AmeenAlShaibani/BLE-RC-car/Docs/Board3D_Back.png

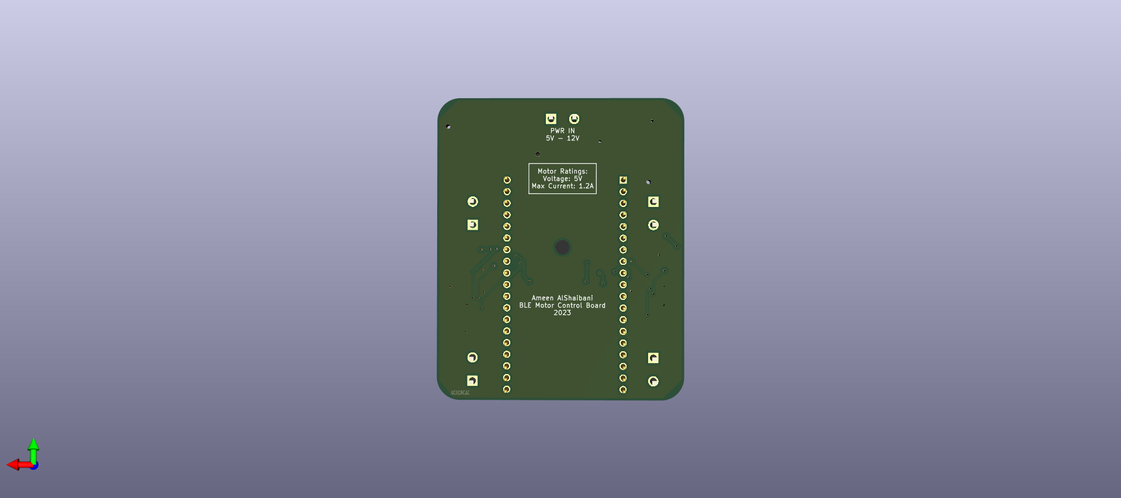
Docs/Board3D_Back.png
