AmeenAlShaibani/BLE-RC-car/README.md

The goal of this project is to create an Android app accompanied by a motherboard for an RC car. The motherboard will handle signal, and power distribution to the motors,
and will use BLE technology to connect to the Android app such that the RC car can be controlled remotely.
