AmeenAlShaibani/BLE-RC-car/Docs/ESP32_BLEPowerConsumption.png

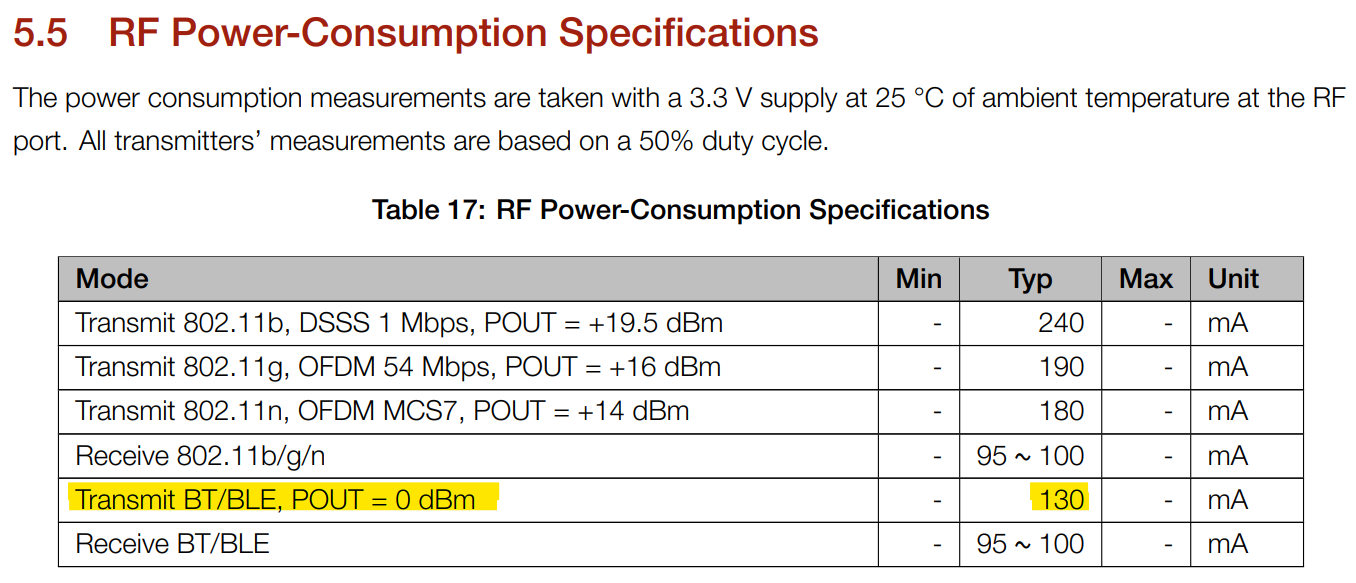
Docs/ESP32_BLEPowerConsumption.png
