AmeenAlShaibani/BLE-RC-car/Manufacturing/production/bom.csv

Designator | Footprint | Quantity | Value | LCSC Part #
C1, C10, C12, C3 | 0402 | 4 | 0.1uF
C11, C13, C2, C4, C5, C8, C9 | 1206 | 7 | 10uF
C6, C7 | CAPMP7343X310N | 2 | 100uF
J1, J2, J3, J4, J5 | 1760490000 | 5 | 1760510000
R1, R2 | 0805 | 2 | 10k
U1 | MODULE_ESP32-DEVKITC-32D | 1 | ESP32-DEVKITC-32D
U2 | SOT95P240X105-3N | 1 | DMG3415U-7 | DMG3415U-7
U3, U4 | SSOP-24_5.3x8.2mm_P0.65mm | 2 | TB6612FNG
U5 | SOT230P700X185-4N | 1 | AZ1117IH-3.3TRG1
U6 | TO-263-3_TabPin2 | 1 | LM1085-5.0
