AmeenAlShaibani/BLE-RC-car/Docs/PowerCalculations.xlsx

Components | Maximum Expected Current Consumption (mA) | Quantity | Total (mA)
ESP32 | 600 | 1 | 600
3-6V DC Motors | 1300 | 4 | 5200
 |  |  | 5800
Battery Requirements
Voltage: | 3.3-6V
Current | 5800
Battery Options
AA Battery: | 1.5V | 2000mAh
D Cell Battery | 1.5V | 15000 mAh | Source | https://www.supplyhog.com/c/electrical/batteries-flashlights/household-batteries/p/duracell-coppertop-alkaline-battery-7
C Cell Battery | 1.5V | 7000 mAh
