AmeenAlShaibani/BLE-RC-car/Docs/BoardSchematic.pdf

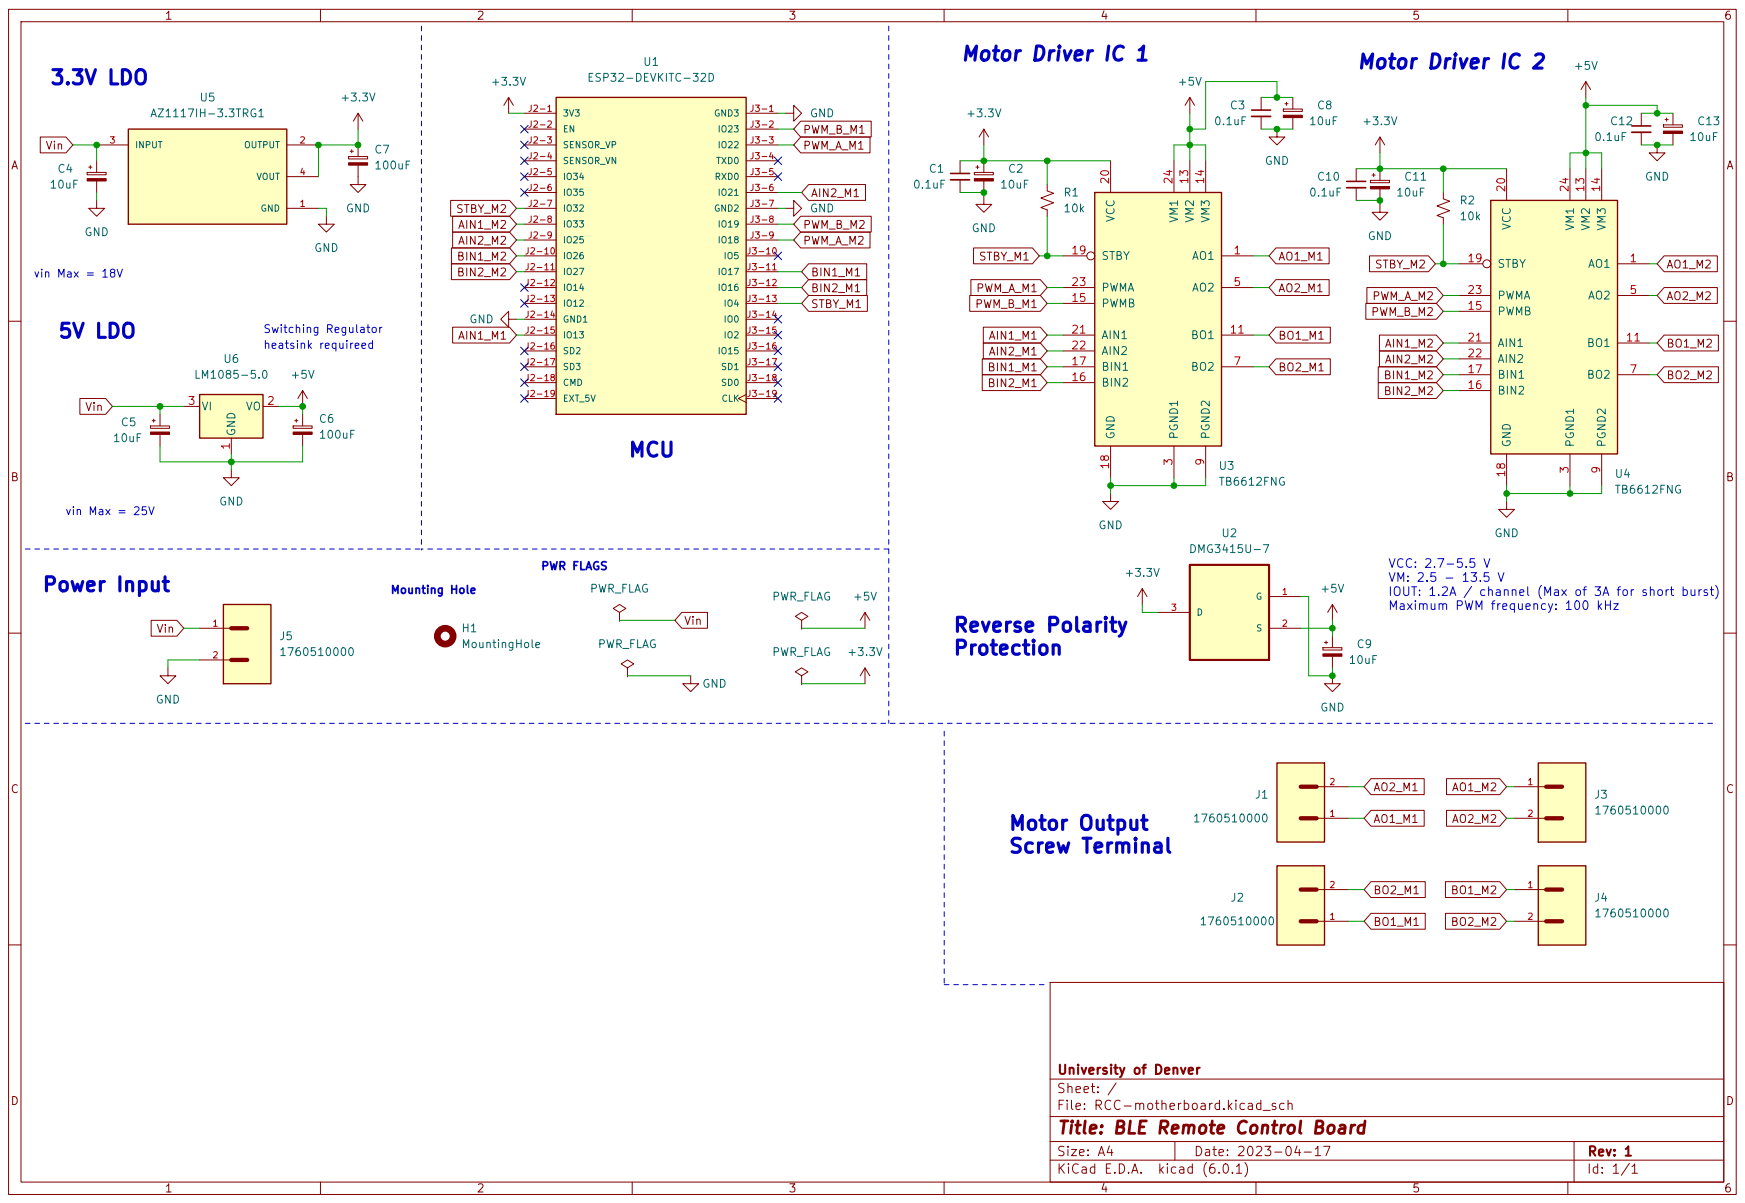
[picture p23: page 1]
