AmeenAlShaibani/BLE-RC-car/Hardware/RCC-motherboard/RCC-motherboard.kicad_pcb

## KiCad design Hardware/RCC-motherboard/RCC-motherboard.kicad_pcb (2023-04-27)

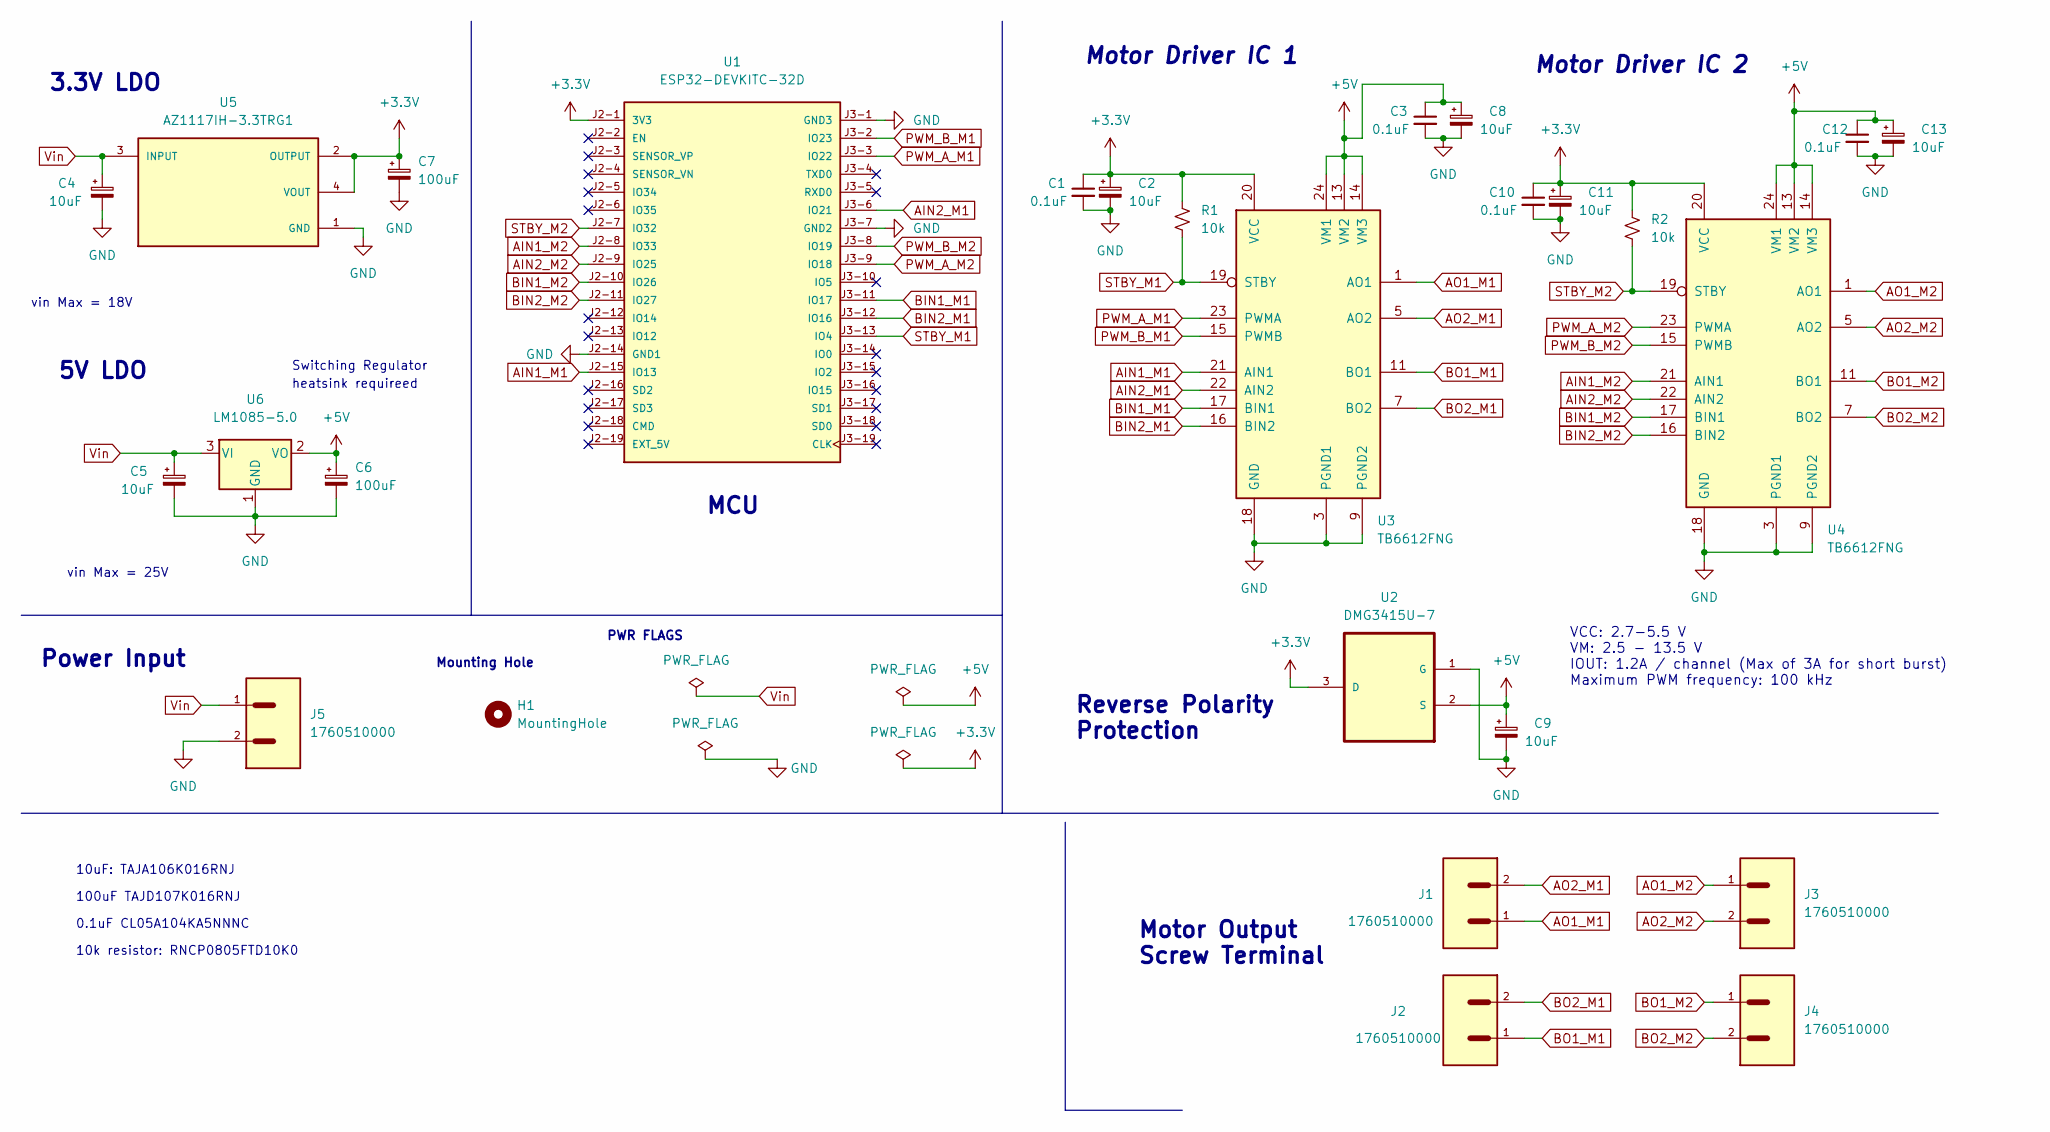
[picture p24: schematic RCC-motherboard.kicad_sch, BLE Remote Control Board]

Parts:
C1, C3, C10, C12: 0.1uF; C_0402_1005Metric
C2, C4, C5, C8, C9, C11, C13: 10uF; C_1206_3216Metric
C6, C7: 100uF; CAPMP7343X310N
H1: MountingHole; MountingHole_3.2mm_M3_ISO7380
J1, J2, J3, J4, J5: 1760510000; 1760490000
R1, R2: 10k; R_0805_2012Metric
U1: ESP32-DEVKITC-32D; MODULE_ESP32-DEVKITC-32D; PARTREV V4
U2: DMG3415U-7; SOT95P240X105-3N; MPN DMG3415U-7
U3, U4: TB6612FNG; SSOP-24_5.3x8.2mm_P0.65mm
U5: AZ1117IH-3.3TRG1; SOT230P700X185-4N; PARTREV 2-2
U6: LM1085-5.0; TO-263-3_TabPin2

Connections:
+3V3: C1.1, C2.1, C7.1, C10.1, C11.1, R1.1, R2.1, U1.J2-1 (3V3), U2.3 (D), U3.20 (VCC), U4.20 (VCC), U5.2 (OUTPUT), U5.4 (VOUT)
AIN1_M1: U1.J2-15 (IO13), U3.21 (AIN1)
AIN1_M2: U1.J2-8 (IO33), U4.21 (AIN1)
AIN2_M1: U1.J3-6 (IO21), U3.22 (AIN2)
AIN2_M2: U1.J2-9 (IO25), U4.22 (AIN2)
AO1_M1: J1.1, U3.1 (AO1), U3.2 (AO1)
AO1_M2: J3.1, U4.1 (AO1), U4.2 (AO1)
AO2_M1: J1.2, U3.5 (AO2), U3.6 (AO2)
AO2_M2: J3.2, U4.5 (AO2), U4.6 (AO2)
BIN1_M1: U1.J3-11 (IO17), U3.17 (BIN1)
BIN1_M2: U1.J2-10 (IO26), U4.17 (BIN1)
BIN2_M1: U1.J3-12 (IO16), U3.16 (BIN2)
BIN2_M2: U1.J2-11 (IO27), U4.16 (BIN2)
BO1_M1: J2.1, U3.11 (BO1), U3.12 (BO1)
BO1_M2: J4.1, U4.11 (BO1), U4.12 (BO1)
BO2_M1: J2.2, U3.7 (BO2), U3.8 (BO2)
BO2_M2: J4.2, U4.7 (BO2), U4.8 (BO2)
GND: C1.2, C2.2, C3.2, C4.2, C5.2, C6.2, C7.2, C8.2, C9.2, C10.2, C11.2, C12.2, C13.2, J5.2, U1.J2-14 (GND1), U1.J3-1 (GND3), U1.J3-7 (GND2), U2.1 (G), U3.3 (PGND1), U3.4 (PGND1), U3.9 (PGND2), U3.10 (PGND2), U3.18 (GND), U4.3 (PGND1), U4.4 (PGND1), U4.9 (PGND2), U4.10 (PGND2), U4.18 (GND), U5.1 (GND), U6.1 (GND)
PWM_A_M1: U1.J3-3 (IO22), U3.23 (PWMA)
PWM_A_M2: U1.J3-9 (IO18), U4.23 (PWMA)
PWM_B_M1: U1.J3-2 (IO23), U3.15 (PWMB)
PWM_B_M2: U1.J3-8 (IO19), U4.15 (PWMB)
STBY_M1: R1.2, U1.J3-13 (IO4), U3.19 (STBY)
STBY_M2: R2.2, U1.J2-7 (IO32), U4.19 (STBY)
Vin: C4.1, C5.1, J5.1, U5.3 (INPUT), U6.3 (VI)

Notes on the sheet:
3.3V LDO
Mounting Hole
0.1uF CL05A104KA5NNNC
Motor Driver IC 1
Reverse Polarity Protection
heatsink requireed
PWR FLAGS
VCC: 2.7-5.5 V VM: 2.5 - 13.5 V IOUT: 1.2A / channel (Max of 3A for short burst) Maximum PWM frequency: 100 kHz
MCU
Motor Output Screw Terminal
5V LDO
100uF TAJD107K016RNJ
Power Input
Motor Driver IC 2
10uF: TAJA106K016RNJ
Switching Regulator
vin Max = 18V
10k resistor: RNCP0805FTD10K0
vin Max = 25V

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
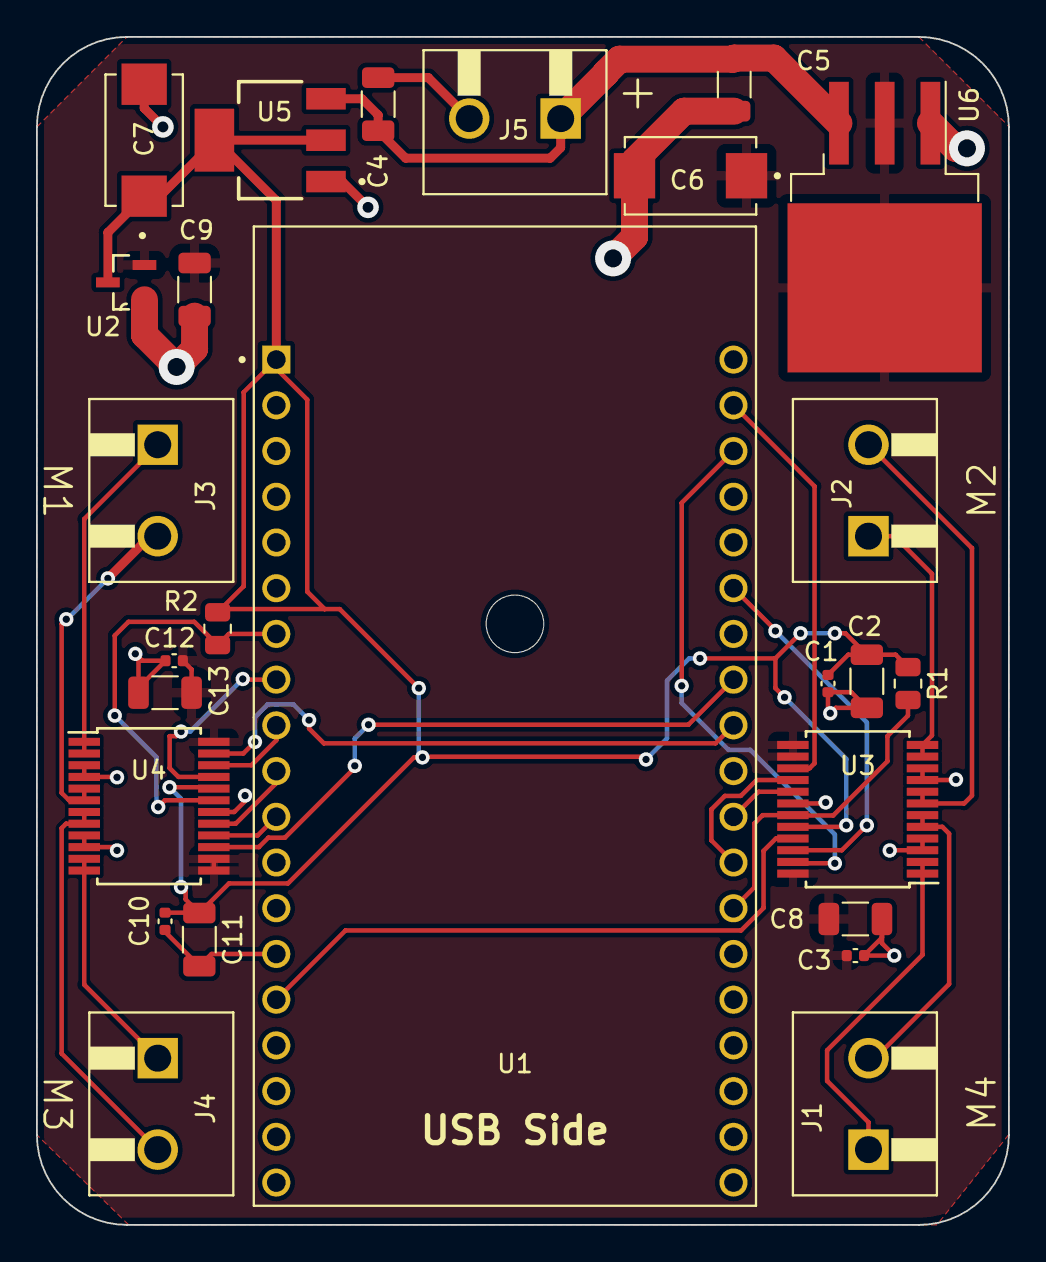
[picture p25: board RCC-motherboard.kicad_pcb from above]

Board: 2 copper layers, 54.0 x 66.0 mm, 27 parts (0 on the bottom side), 26 nets.
