AmeenAlShaibani/BLE-RC-car/(commit log)

2023-02-28 Added documentation
    [PowerCalculations.xlsx]
2023-03-26 Added Motor driver IC
    [PowerCalculations.xlsx, RCC-motherboard.kicad_sch]
2023-04-03 Added voltage regulators to kicad schematic
2023-04-05 Designed rough layout for board
    [RCC-motherboard.kicad_pcb, RCC-motherboard.kicad_sch]
2023-04-09 Finished PCB Layout
    [RCC-motherboard.kicad_pcb, RCC-motherboard.kicad_sch]
2023-04-12 Produced Gerber and Production files
    [RCC-motherboard.kicad_pcb, RCC-motherboard.kicad_sch, bom.csv, designators.csv, positions.csv]
2023-04-13 Size standarized to mm, and board is ordered
    [RCC-motherboard.kicad_pcb, positions.csv]
2023-04-19 Created inital Paper Draft
    [RCC-motherboard.kicad_sch]
2023-04-27 Board uses ESP32-DEVKITC not narrow version
    [RCC-motherboard.kicad_pcb]
